palotfathima/Investigating-the-SAC-of-3D-Printed-PLA-Discs-with-Varying-Perforation-Geometries/Images/29CIRC.png

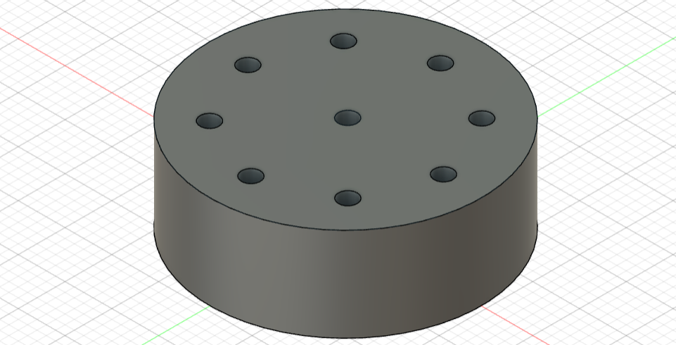
Images/29CIRC.png
