palotfathima/Investigating-the-SAC-of-3D-Printed-PLA-Discs-with-Varying-Perforation-Geometries/Images/29TRI.png

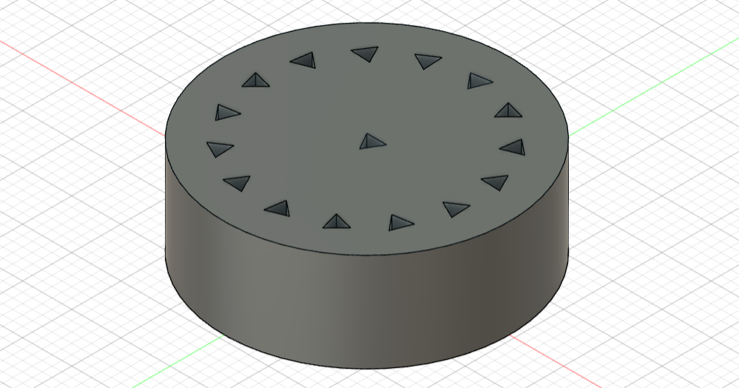
Images/29TRI.png
