palotfathima/Investigating-the-SAC-of-3D-Printed-PLA-Discs-with-Varying-Perforation-Geometries/Images/100CIRC.png

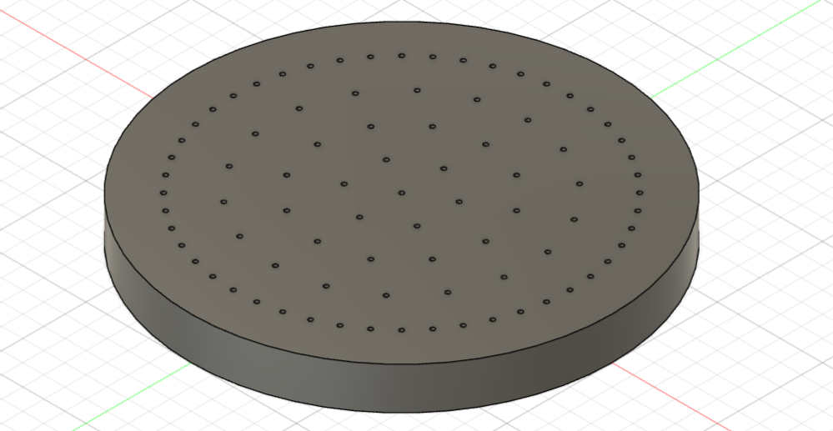
Images/100CIRC.png
