palotfathima/Investigating-the-SAC-of-3D-Printed-PLA-Discs-with-Varying-Perforation-Geometries/Results.pdf

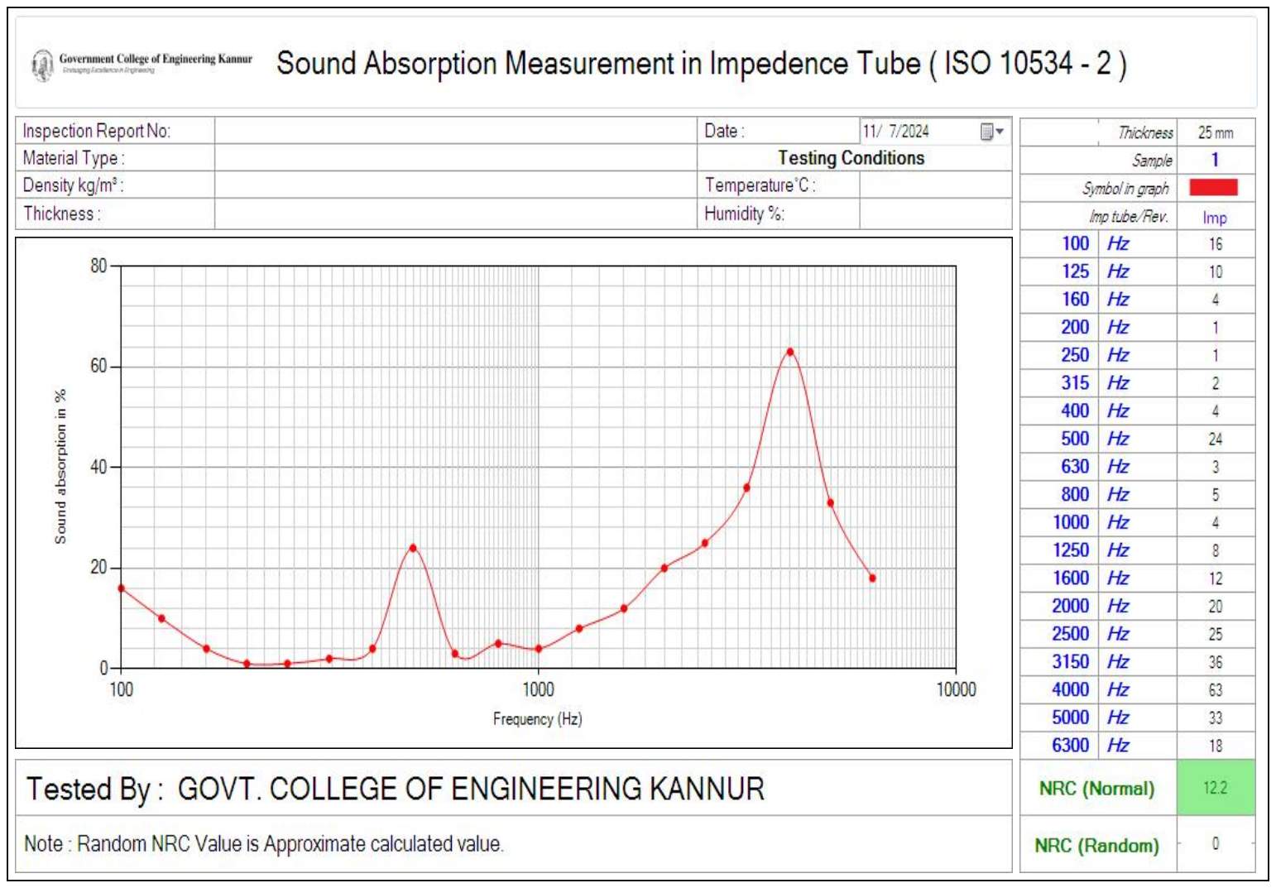
[picture p20: page 1]
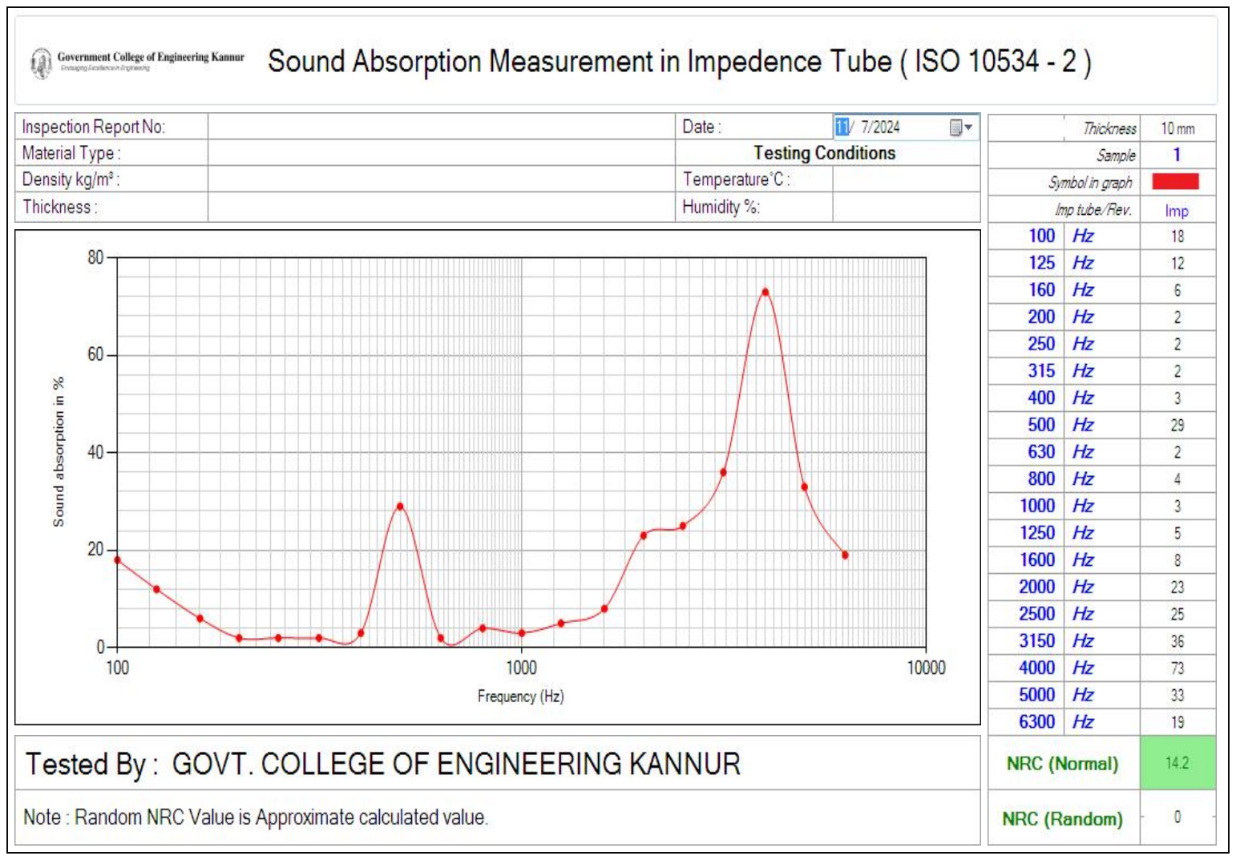
[picture p21: page 2]
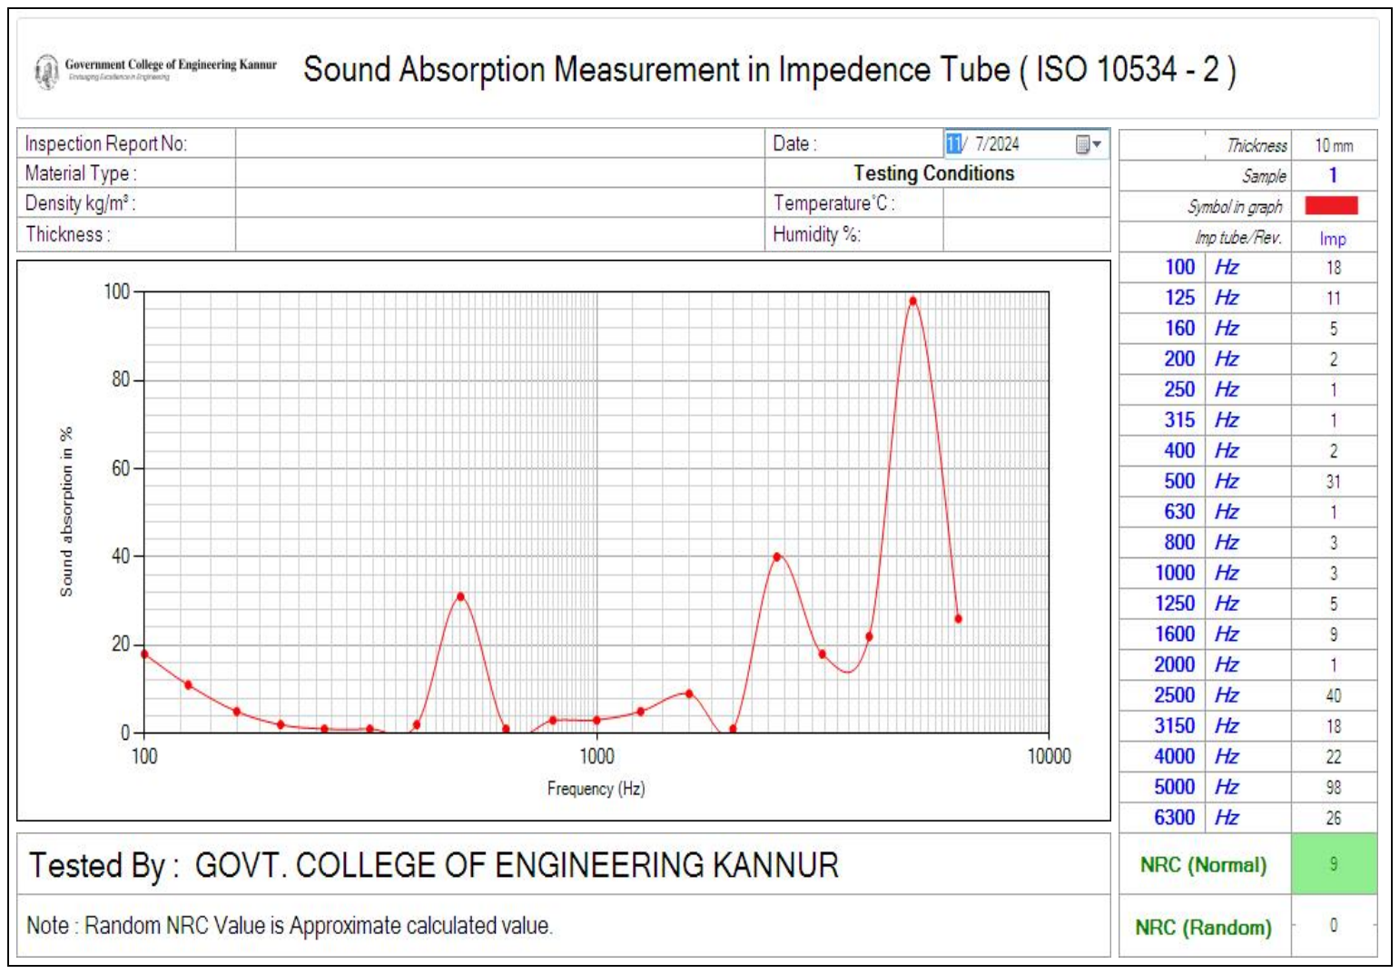
[picture p22: page 3]
