palotfathima/Investigating-the-SAC-of-3D-Printed-PLA-Discs-with-Varying-Perforation-Geometries/3D Models/100 CIRC.stl

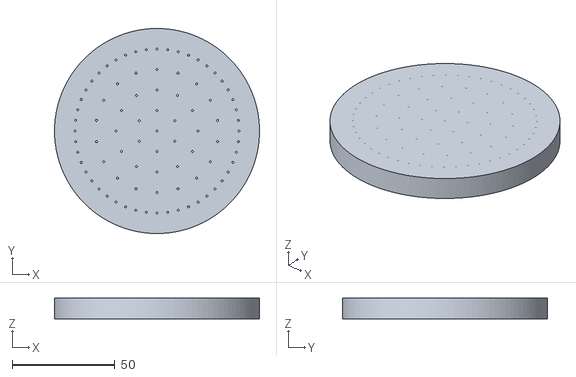
[picture p16: CAD file, 2026-11-12]
3D Models/100 CIRC.stl
100.0 x 100.0 x 10.0
