palotfathima/Investigating-the-SAC-of-3D-Printed-PLA-Discs-with-Varying-Perforation-Geometries/3D Models/29 CIRC.stl

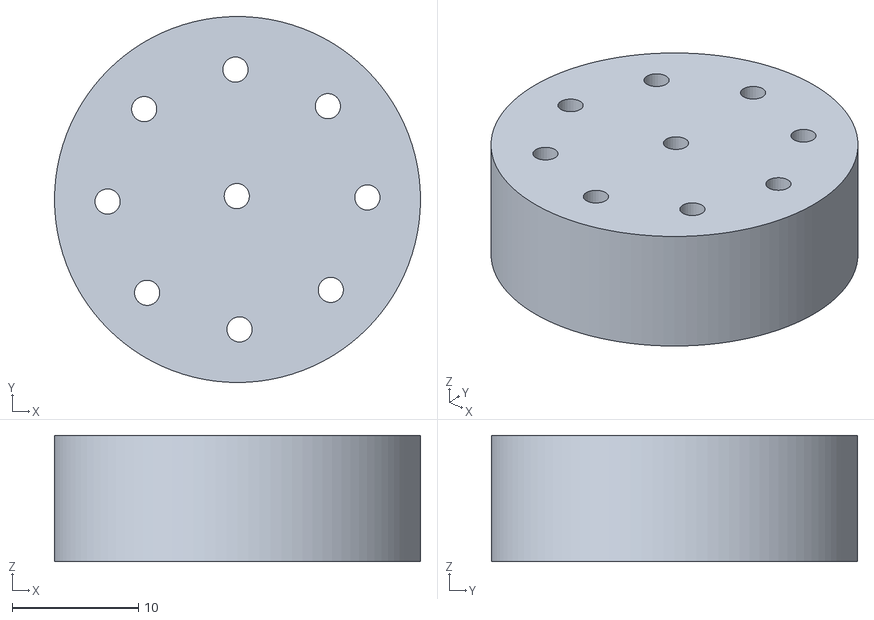
[picture p17: CAD file, 2026-11-12]
3D Models/29 CIRC.stl
29.0 x 29.0 x 10.0
