palotfathima/Investigating-the-SAC-of-3D-Printed-PLA-Discs-with-Varying-Perforation-Geometries/3D Models/29 TRI.stl

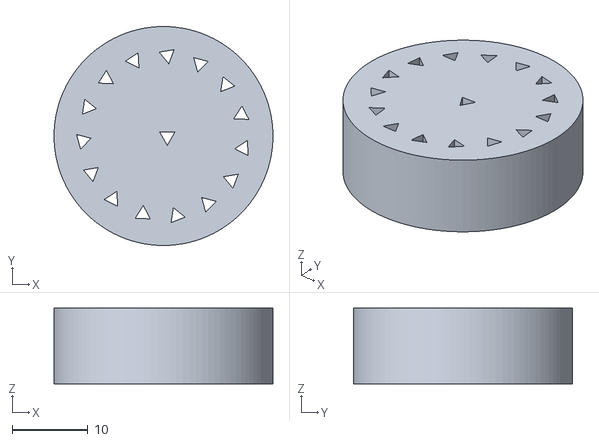
[picture p18: CAD file, 2026-11-12]
3D Models/29 TRI.stl
29.0 x 29.0 x 10.0
