palotfathima/Investigating-the-SAC-of-3D-Printed-PLA-Discs-with-Varying-Perforation-Geometries/3D Models/100 TRI.stl

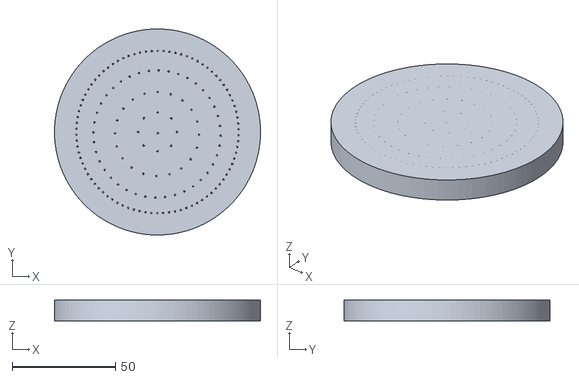
[picture p19: CAD file, 2026-11-12]
3D Models/100 TRI.stl
100.0 x 100.0 x 10.0
