palotfathima/Investigating-the-SAC-of-3D-Printed-PLA-Discs-with-Varying-Perforation-Geometries/(list of files, cad)

Other CAD files:
3D Models/100 SQU.stl
3D Models/29 SQU.stl
